muztahiddurjoy/gorur_gari_2026/firmware/i2c_addresses.md

# I2C bus: SDA GPIO8 / SCL GPIO9, 400 kHz (falls back to 100 kHz if the gyro is unreliable)

# OLED DISPLAY (SSD1306): 0x3C
# BOTGyro IMU (ASM330LHH): 0x6A (0x6B if SA0 is tied high)
