muztahiddurjoy/gorur_gari_2026/circuit_diagram/esp32_pin_map.png

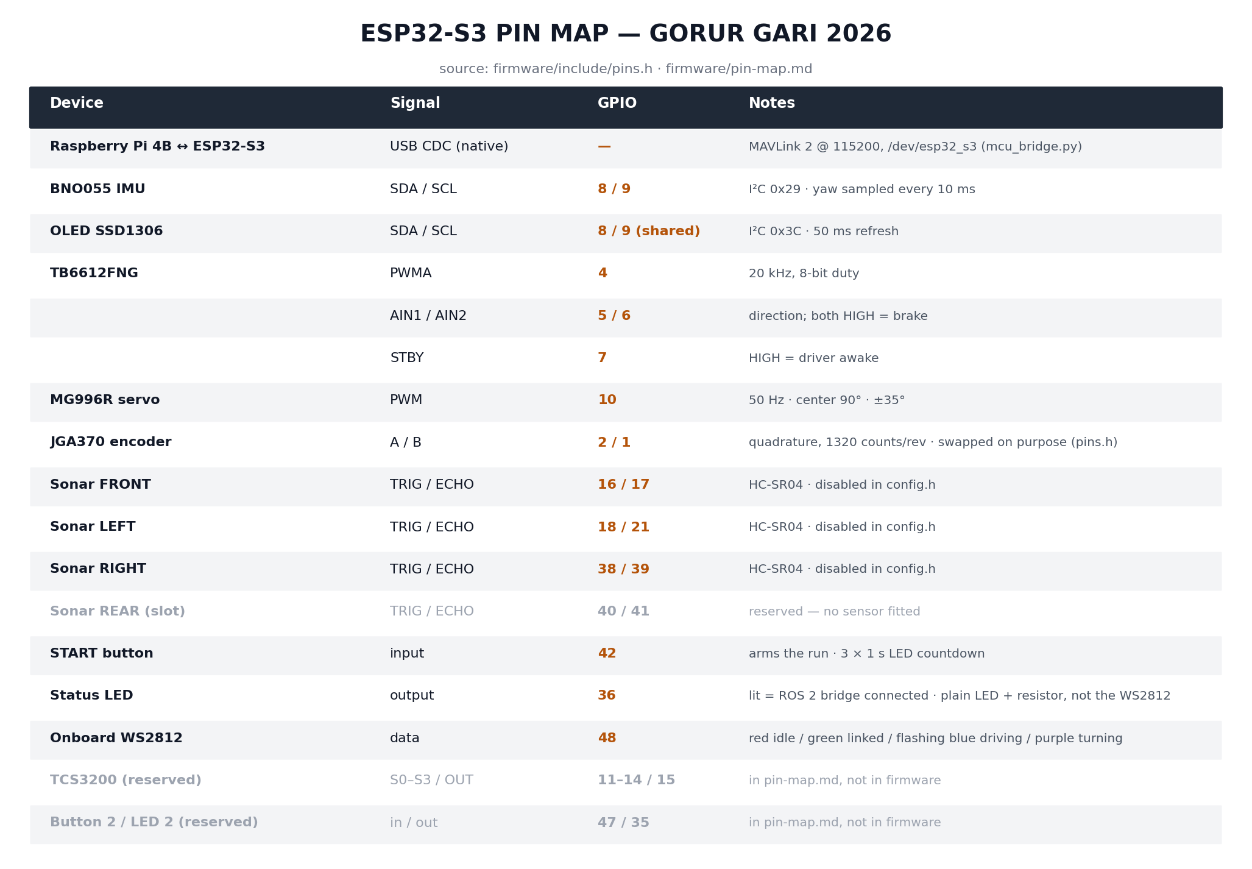
circuit_diagram/esp32_pin_map.png
