muztahiddurjoy/gorur_gari_2026/CAD/gorusim_collision.step

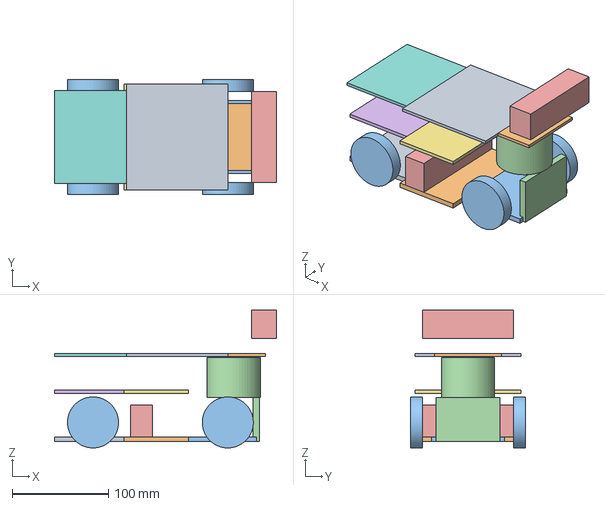
[picture p6: CAD file, 2026-11-05]
CAD/gorusim_collision.step
230.5 x 119.0 x 143.2 mm
