muztahiddurjoy/gorur_gari_2026/gorusim/meshes/camera_link__333.stl

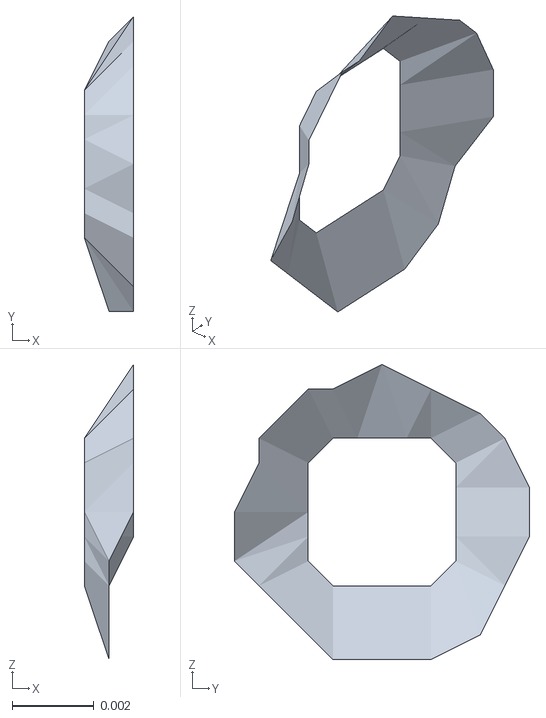
[picture p7: CAD file, 2026-11-05]
gorusim/meshes/camera_link__333.stl
0.0012 x 0.0072 x 0.0072
