muztahiddurjoy/gorur_gari_2026/gorusim/meshes/rear_axle__400.stl

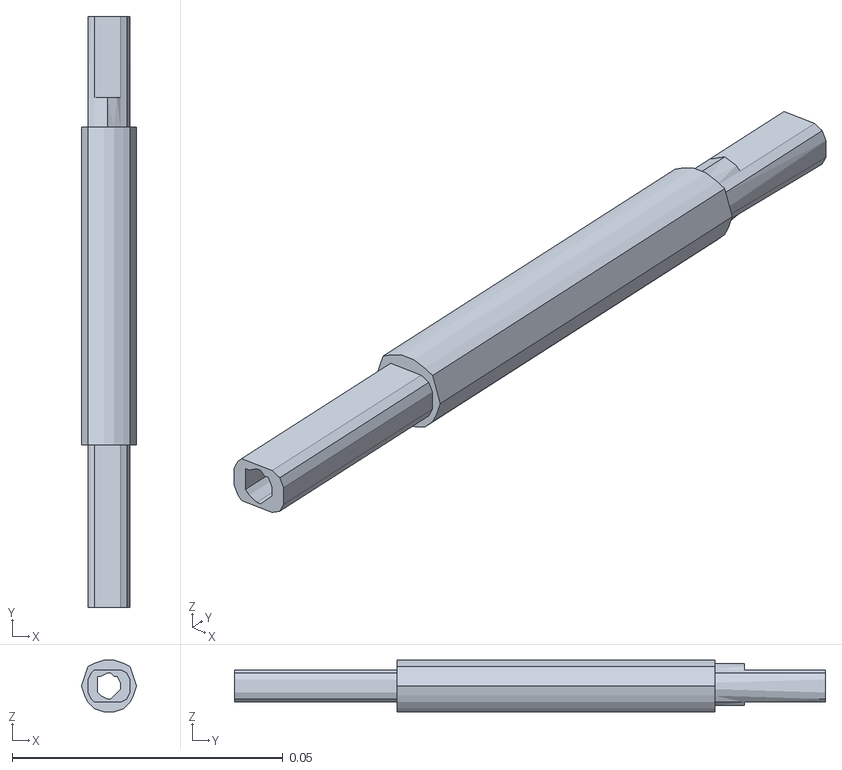
[picture p8: CAD file, 2026-11-05]
gorusim/meshes/rear_axle__400.stl
0.0102 x 0.109 x 0.0096
