muztahiddurjoy/gorur_gari_2026/gorusim/meshes/base_link__555.stl

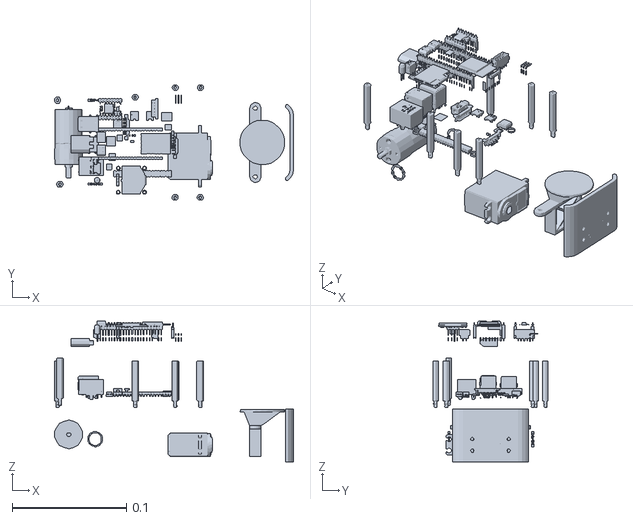
[picture p9: CAD file, 2026-11-05]
gorusim/meshes/base_link__555.stl
0.209 x 0.101 x 0.123
