muztahiddurjoy/gorur_gari_2026/gorusim/meshes/base_link__700.stl

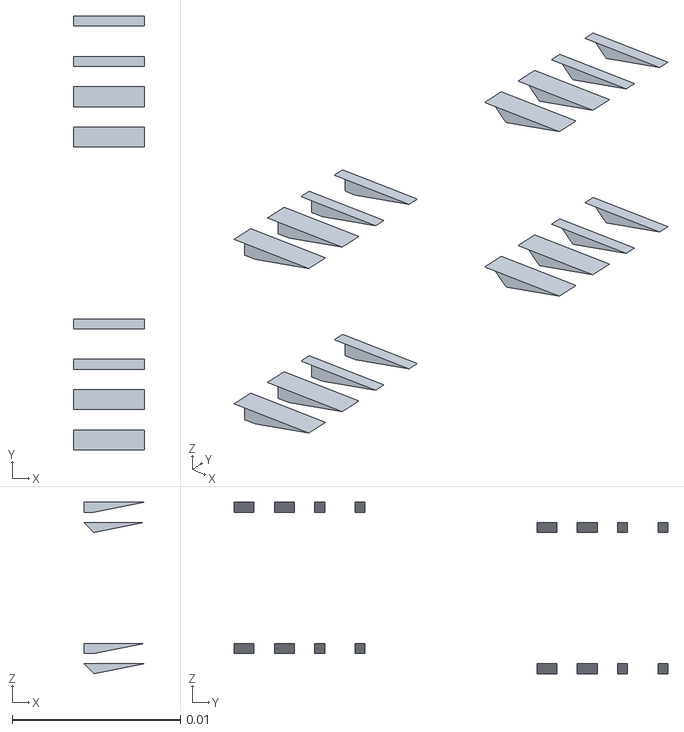
[picture p10: CAD file, 2026-11-05]
gorusim/meshes/base_link__700.stl
0.0042 x 0.0258 x 0.0102
