muztahiddurjoy/gorur_gari_2026/gorusim/meshes/base_link__777.stl

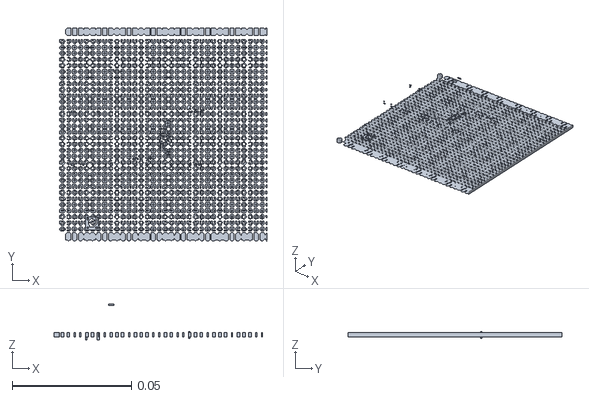
[picture p11: CAD file, 2026-11-05]
gorusim/meshes/base_link__777.stl
0.0894 x 0.09 x 0.015
