muztahiddurjoy/gorur_gari_2026/gorusim/meshes/camera_link__000.stl

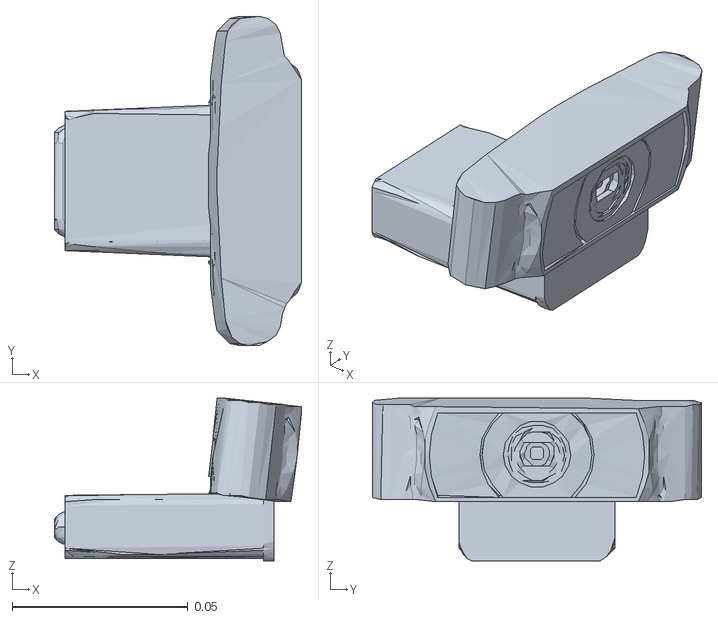
[picture p12: CAD file, 2026-11-05]
gorusim/meshes/camera_link__000.stl
0.0702 x 0.0936 x 0.0462
