muztahiddurjoy/gorur_gari_2026/gorusim/meshes/imu_link__222.stl

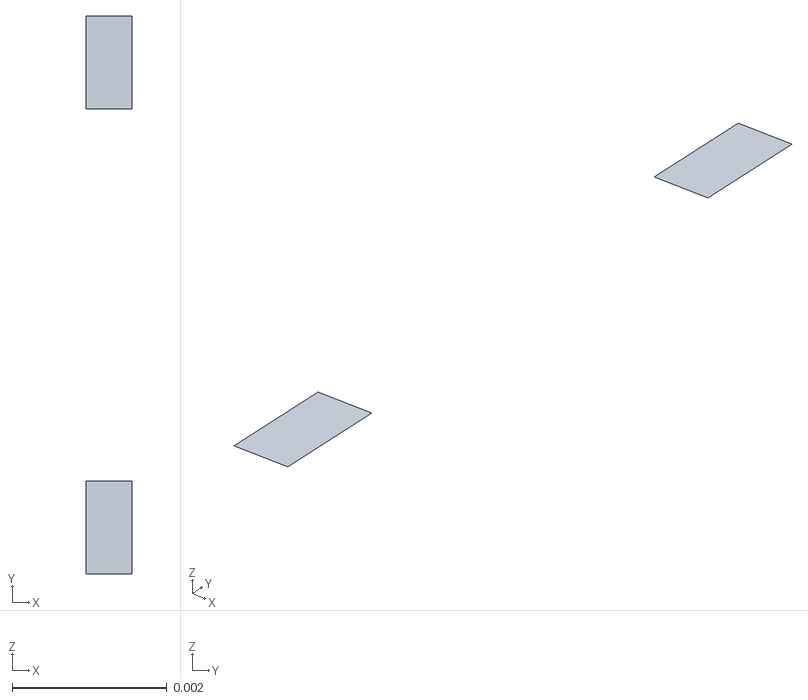
[picture p13: CAD file, 2026-11-05]
gorusim/meshes/imu_link__222.stl
0.0006 x 0.0072 x 0
