muztahiddurjoy/gorur_gari_2026/gorusim/meshes/base_link__000.stl

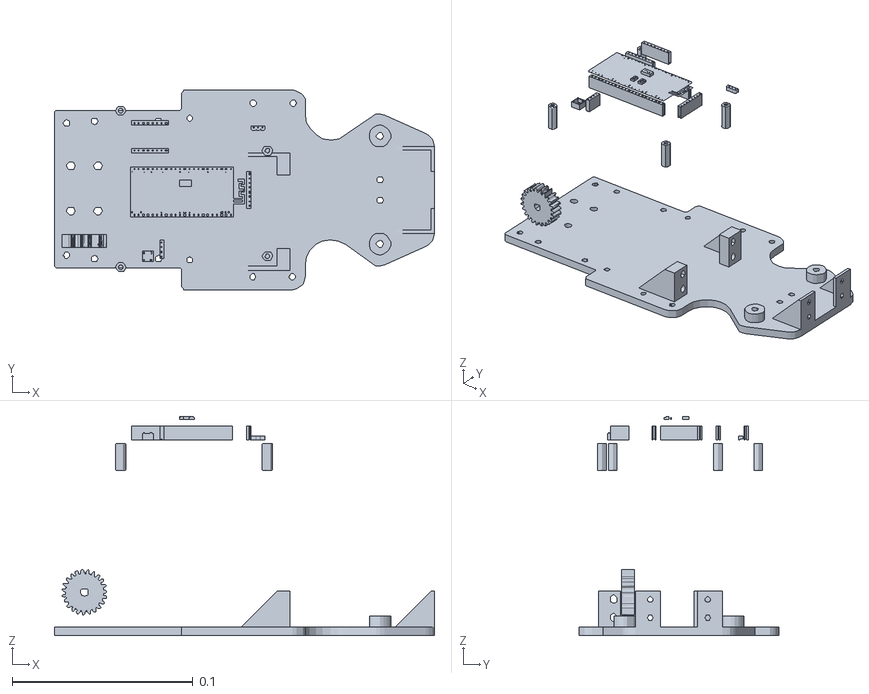
[picture p14: CAD file, 2026-11-05]
gorusim/meshes/base_link__000.stl
0.21 x 0.11 x 0.121
