muztahiddurjoy/gorur_gari_2026/gorusim/meshes/base_link__111.stl

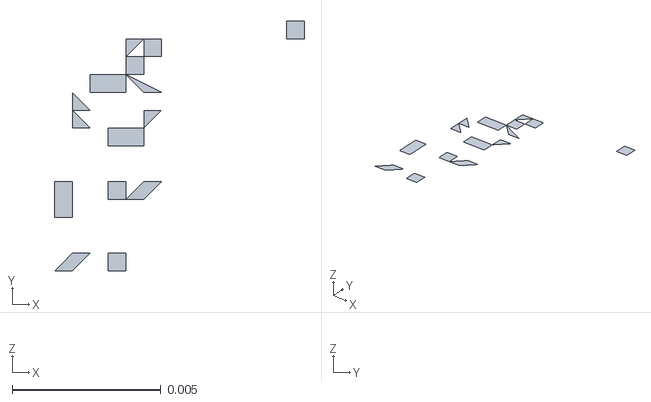
[picture p15: CAD file, 2026-11-05]
gorusim/meshes/base_link__111.stl
0.0084 x 0.0084 x 0
