muztahiddurjoy/gorur_gari_2026/gorusim/meshes/base_link__666.stl

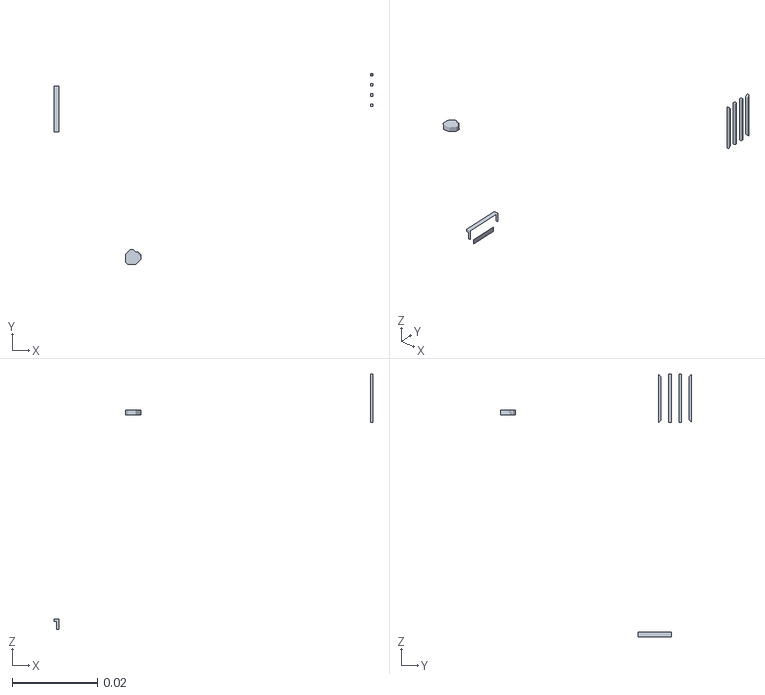
[picture p16: CAD file, 2026-11-05]
gorusim/meshes/base_link__666.stl
0.075 x 0.045 x 0.0618
