muztahiddurjoy/gorur_gari_2026/gorusim/meshes/camera_link__444.stl

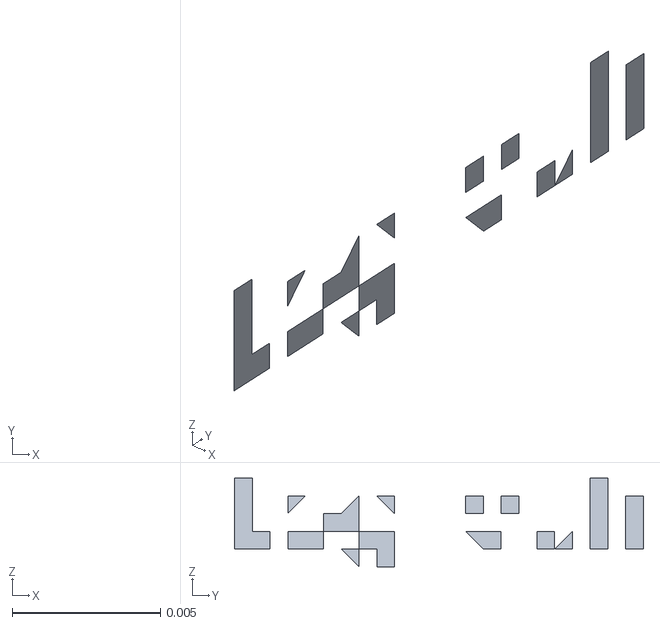
[picture p17: CAD file, 2026-11-05]
gorusim/meshes/camera_link__444.stl
0 x 0.0138 x 0.003
