muztahiddurjoy/gorur_gari_2026/gorusim/meshes/laser__555.stl

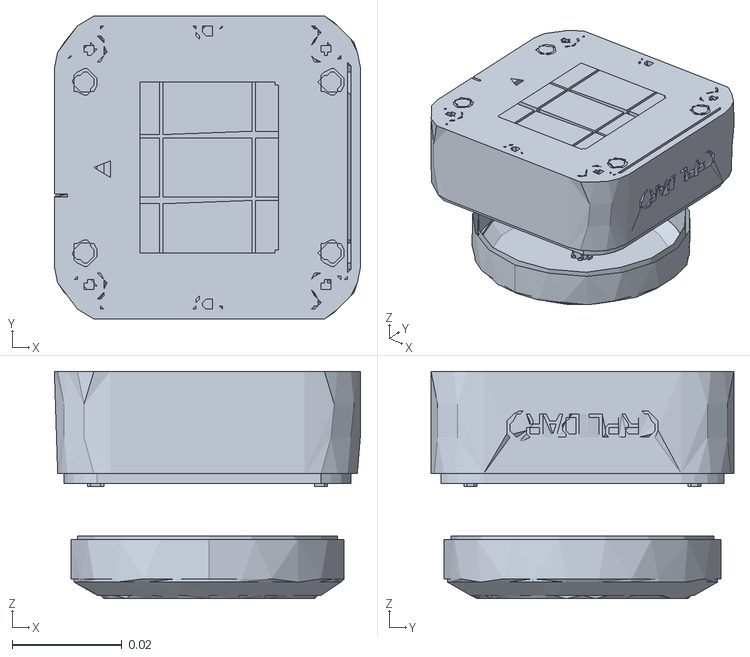
[picture p18: CAD file, 2026-11-05]
gorusim/meshes/laser__555.stl
0.0558 x 0.0552 x 0.0414
