muztahiddurjoy/gorur_gari_2026/gorusim/meshes/base_link__800.stl

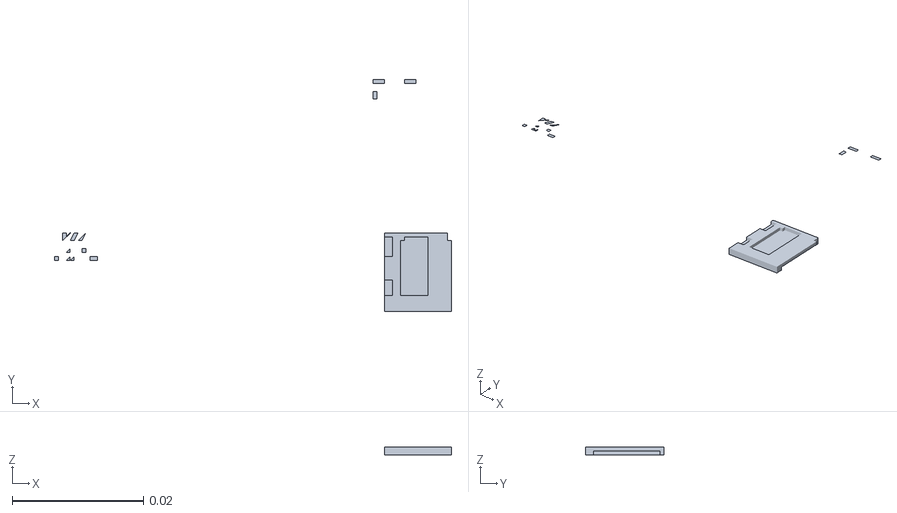
[picture p19: CAD file, 2026-11-05]
gorusim/meshes/base_link__800.stl
0.0606 x 0.0354 x 0.0042
