muztahiddurjoy/gorur_gari_2026/gorusim/meshes/base_link__024.stl

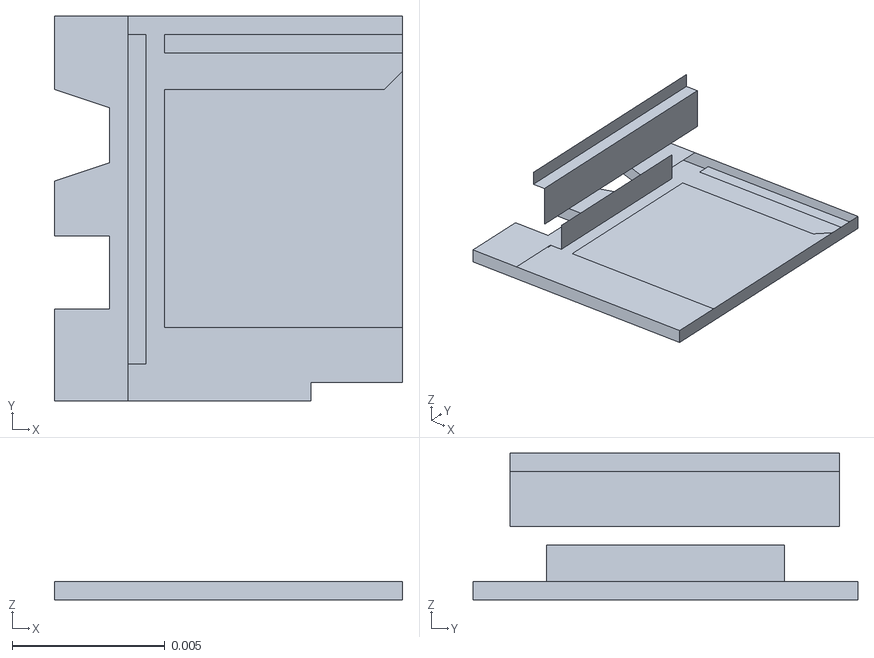
[picture p20: CAD file, 2026-11-05]
gorusim/meshes/base_link__024.stl
0.0114 x 0.0126 x 0.0048
