muztahiddurjoy/gorur_gari_2026/gorusim/meshes/imu_link__555.stl

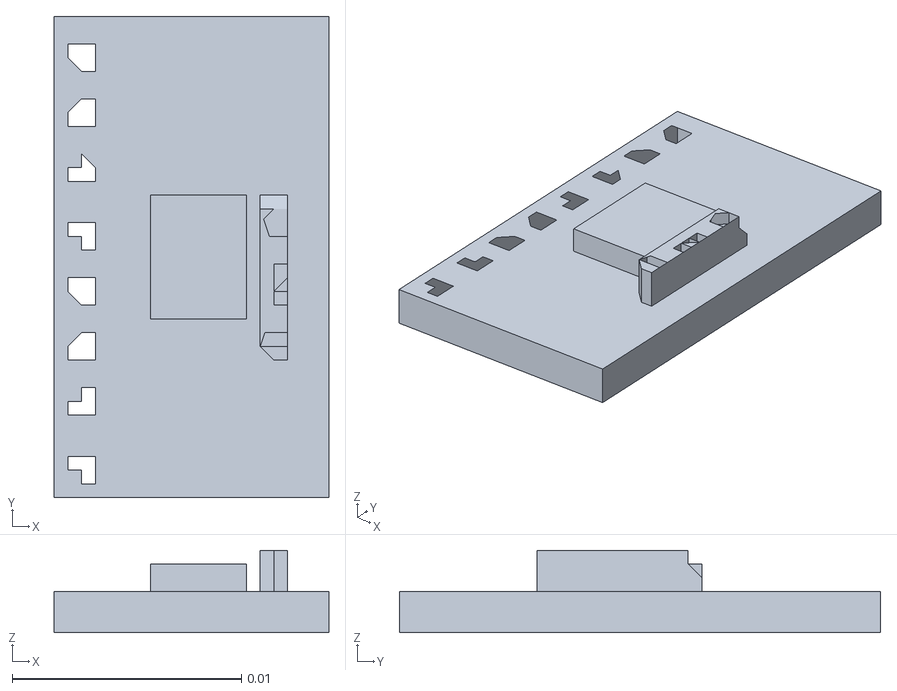
[picture p21: CAD file, 2026-11-05]
gorusim/meshes/imu_link__555.stl
0.012 x 0.021 x 0.0036
