muztahiddurjoy/gorur_gari_2026/gorusim/meshes/base_link__820.stl

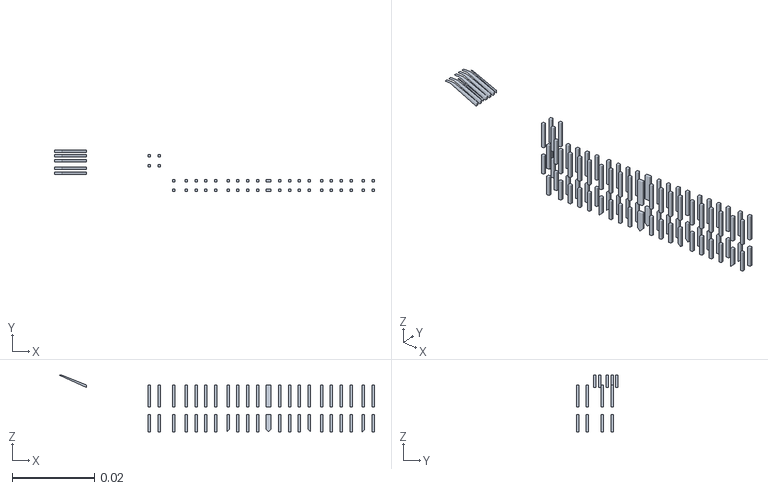
[picture p22: CAD file, 2026-11-05]
gorusim/meshes/base_link__820.stl
0.078 x 0.0108 x 0.0138
