muztahiddurjoy/gorur_gari_2026/gorusim/meshes/base_link__021.stl

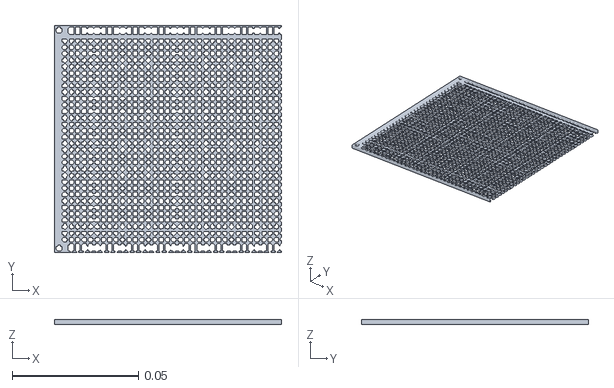
[picture p23: CAD file, 2026-11-05]
gorusim/meshes/base_link__021.stl
0.09 x 0.09 x 0.0018
