muztahiddurjoy/gorur_gari_2026/gorusim/meshes/base_link__151.stl

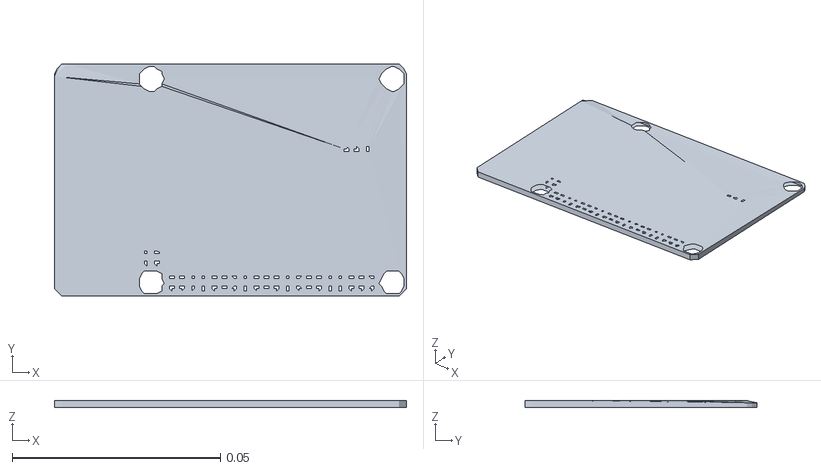
[picture p24: CAD file, 2026-11-05]
gorusim/meshes/base_link__151.stl
0.0846 x 0.0558 x 0.0018
