muztahiddurjoy/gorur_gari_2026/gorusim/meshes/base_link__222.stl

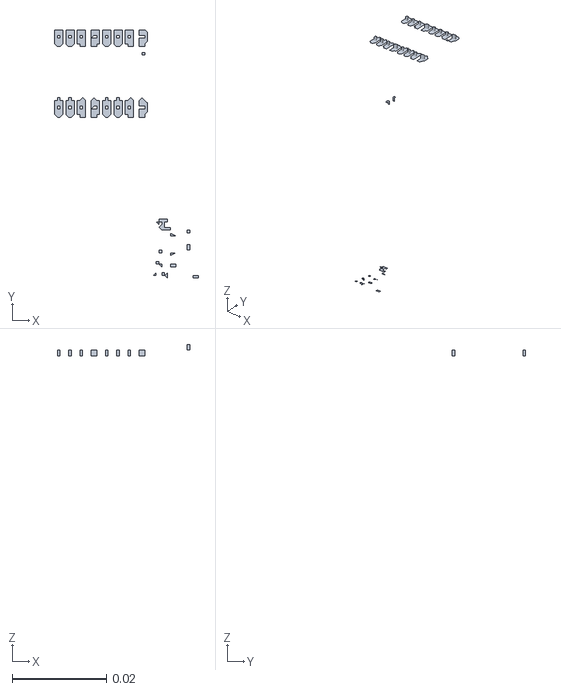
[picture p25: CAD file, 2026-11-05]
gorusim/meshes/base_link__222.stl
0.0306 x 0.0528 x 0.0612
