muztahiddurjoy/gorur_gari_2026/gorusim/meshes/base_link__763.stl

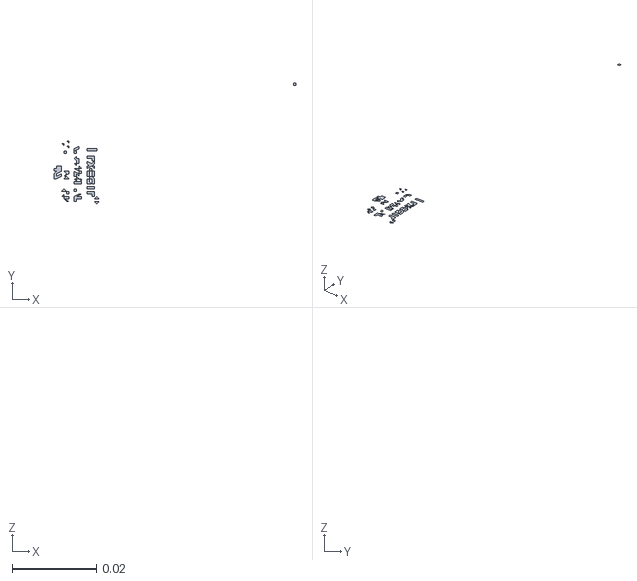
[picture p26: CAD file, 2026-11-05]
gorusim/meshes/base_link__763.stl
0.0576 x 0.0288 x 0.0474
