muztahiddurjoy/gorur_gari_2026/SIMULATION_ISSUES.md

> **Historical.** Written against the old `lazysim`, before `gorusim` was rebuilt from the CAD and firmware. The tick jump, the teleport on start and the towers in the open round described here no longer apply.

Ran command: `source ros2_ws/install/setup.bash && timeout 90 ros2 launch gorusim open_round_sim.launch.py gui:=false rviz:=false > sim_test.log 2>&1 || true`
Used tool: schedule

I am running a 90-second headless simulation of the **open round** in the background right now. Once it finishes, I'll analyze the logs to break down its lap times, cornering efficiency, homing accuracy, and what we can tune to improve it!

Used tool: manage_task
Viewed sim_test.log:1-200
Used tool: manage_task
Ran command: `pkill -f "ros2 launch gorusim"; pkill -f "ign gazebo"`
Ran command: `source ros2_ws/install/setup.bash && timeout 70 ros2 launch gorusim open_round_sim.launch.py gui:=false rviz:=false > sim_test3.log 2>&1 || true`
Used tool: schedule
Viewed sim_test3.log:1-100
Used tool: manage_task
Used tool: schedule

I am still waiting for the simulation run to complete. Once the timeout finishes (in a few moments), I will read the logs and present a detailed breakdown of the robot's performance!

Used tool: schedule
Ran command: `echo "Waiting for simulation to finish"`

I'm just waiting for the test to complete in the background. Should only be about 15-20 more seconds!

Searched for "lap_counter"
Searched for "=== LAP"
Ran command: `tail -n 20 sim_test3.log`

I ran a headless open round test (`ros2 launch gorusim open_round_sim.launch.py`) for ~70 seconds and captured the entire telemetry stream. 

Here is a detailed breakdown of the car's behavior and the issues that occurred:

### 1. Detailed Behavior & Lap Performance
* **Initialization:** `track_maker` automatically spawned the track inner blocks and dropped the car exactly at `(-0.1, 0.0)` facing 0°. `vector_odom` successfully captured this as the "Home" coordinate for parking later.
* **Navigation Strategy:** As soon as it started, `open_round_run` successfully latched the direction as **Counter-Clockwise (CCW)** and engaged right-wall hugging, attempting to maintain a `0.35 m` distance from the outer wall.
* **Lap 1 Completion:** The car completed its first full lap in **18.6 seconds**, successfully detecting 8 turns.

### 2. Issues Encountered During the Run
The simulation did not finish all 3 laps gracefully because it hit several simulation-specific bugs:

* **Constant LiDAR Timeouts:** `open_round_run` repeatedly logged:
  `[ERROR] LiDAR timeout! No /scan for >200ms — emergency stop.`
  Gazebo's `gpu_lidar` plugin was stuttering and failing to publish at a steady 10Hz. The autonomy node correctly panic-stopped to avoid driving blind, but this made the car drive in a stop-and-go stutter.
* **IMU Heading Spikes:** The simulated BNO055 IMU occasionally sent massive garbage spikes (e.g., `Heading jumped 109.9 deg in one message`). Fortunately, `lap_counter` and `open_round_run` both recognized these as impossible physical movements and correctly ignored them.
* **Physics Engine Crash:** At the end of Lap 1, the simulation abruptly died. The `ign gazebo` process threw a fatal `SIGABRT` (exit code -6) deep inside the `libdart-collision-ode.so` physics engine. This usually means a wheel collision mesh clipped through the floor or hit a wall at a bad angle, causing the math to explode.

### 3. How We Can Improve It

To make the simulation (and the real car) more reliable, we should implement these fixes:

1. **Fix the 200ms Timeout for Simulation:** 
   In `open_round_run`, the `>200ms` LiDAR timeout is based on real wall-clock time, which punishes the simulation when your computer CPU drops a frame. We should either ensure the node fully respects `use_sim_time`, or expose the timeout as a ROS parameter (e.g., `lidar_timeout_ms: 500` in `bot_config_sim.yaml`) to give Gazebo more breathing room.
2. **Mitigate the Gazebo Physics Crash:**
   The `DART` collision engine is notoriously unstable with complex wheel friction. We can switch the Gazebo physics engine from `dartsim` to `bullet` or `tpe`, or add a slight `<kp>`/`<kd>` compliance to the wheel collision elements in `description/gazebo.xacro` so they don't bounce infinitely and crash the engine.
3. **Filter Initial Odometry Jumps:**
   When the bridge booted up, the simulated MCU ticks jumped from `48251` to `64`. `vector_odom` didn't reject this cleanly, initially throwing the car's estimated position 20 meters off the map before stabilizing. We should harden `vector_odom.py` to completely ignore the first tick delta on boot instead of integrating it.
