muztahiddurjoy/gorur_gari_2026/(commit log)

2026-08-03 updated for esp32 s3
2026-08-03 Add build logs for 'contols' package installation
    - Created stdout_stderr.log to capture the output of the egg_info, build, and install processes for the 'contols' package.
    - Added streams.log to log the command execution details and its output during the build process.
    - Introduced events.log to track the job lifecycle events, including job queuing, starting, and ending.
    - Generated logger_all.log to provide a comprehensive debug log of the colcon build process, including command line arguments, package discovery, and environment setup.
2026-08-03 motor rear drive issue resolved
    [main.cpp]
2026-08-04 created the display driver
2026-08-04 Add updateScreen method and button handler files
2026-08-05 Add sonar functionality and debug serial logging
    - Introduced SonarReader class for ultrasonic sensor handling.
    - Added sonar pins and configuration in config.h and pins.h.
    - Integrated sonar readings into main loop for telemetry.
    - Updated mcu_bridge.py to publish sonar data to ROS2 topics.
    - Implemented debug serial logging to avoid MAVLink desynchronization.
    [config.h, debug_serial.h, main.cpp, mcu_bridge.py, pins.h]
2026-08-05 Add sonar functionality with enable flags and update ROS2 bridge for sonar integration
2026-08-05 Add build logs for 'contols' package
    - Created stdout_stderr.log to capture standard output and error during the build process.
    - Added streams.log to log the command execution details and output.
    - Introduced events.log to track events during the build lifecycle, including job status and command execution.
    - Generated logger_all.log for comprehensive logging of the build process, including command line arguments and package discovery details.
    [main.cpp, mcu_bridge.py]
2026-08-05 working on the status LED
2026-08-06 Remove status LED functionality and related configurations
2026-08-06 Add velocity data handling to SharedData and update display logic
2026-08-07 sending raw data to the ros2 side for yaw and encoder tick
2026-08-07 attempting to auto steer based on lidar response
2026-08-07 Added fix of claude generated issues
    [disparity_extender.py, disparity_extender_params.yaml]
2026-08-08 Implement BoxLapTestNode for autonomous steering based on odometry and heading inputs
2026-08-08 added push button code
2026-08-08 implemented the button node
2026-08-08 Add status LED functionality and connection message for ROS2 bridge
    - Introduced STATUS_LED_PIN for a plain LED to indicate ROS2 connection status.
    - Updated StatusLed class to manage a single color LED instead of NeoPixel.
    - Implemented connection message (gorur_gari_ros2_to_mcu_connect_msg) to notify MCU of ROS2 bridge status.
    - Modified main loop to handle connection status and update LED accordingly.
    - Adjusted platformio.ini to remove NeoPixel dependency.
2026-08-08 added the status led
2026-08-09 i2c issue resolved
2026-08-09 Enhance GoToController with detailed comments and parameter adjustments for improved steering and heading management
2026-08-09 Add heading offset parameter to GoToController, EncoderOdometryNode, and VectorOdometryNode for accurate heading calculations
2026-08-09 Enhance GoToController with adaptive speed control, goal queue management, and improved steering logic; update VectorOdometryNode to correctly accumulate total distance travelled.
    [goto_controller.py, vector_odom.py]
2026-08-09 Fix encoder pin assignments and update heading offset parameters for consistency across odometry nodes
    [goto_controller.py, pins.h, vector_odom.py]
2026-08-09 Add HSV tuning utility and vision processing node for WRO 2026
    - Implemented `tune_hsv.py`, an interactive tool for tuning HSV parameters and thresholds for detecting red and green pillars using OpenCV and Tkinter.
    - Created `vision_node.py`, a ROS 2 node that subscribes to camera images, applies color mask filtering for pillar detection, and publishes identified obstacles.
    - Introduced `vector_odom.py`, a vector odometry node that calculates position vectors based on encoder data and IMU heading, publishing the results as a Vector3 message.
2026-08-09 Implement start button functionality with countdown and LED indication
2026-08-10 Add CustomDisparityExtender node for enhanced laser scan processing
2026-08-10 Refactor and remove obsolete sensor processing modules
    - Deleted `encoder_odometry.py` and `vector_odom.py` files as they are no longer needed.
    - Removed associated build files and configurations related to the deleted modules.
    - Updated `custom_disparity_extender.py` to enhance disparity edge detection and object width measurement.
    - Improved code structure and added detailed comments for clarity.
    - Updated build logs to reflect the latest changes.
    [custom_disparity_extender.py]
2026-08-10 remove draft vision node package and implement new camera push detector node
2026-08-10 Resolve merge conflict, keep 3 lap auto off and reset lap count at start
    [disparity_extender.py]
2026-08-10 tried new method for fusion (reverrt commit if something goes wrong)
    [disparity_extender.py, disparity_extender_params.yaml, vision_node.py, vision_params.yaml]
2026-08-10 Refactor E-Stop Node for Improved Safety and Functionality
    - Reindented the entire e_stop.py file for proper syntax and readability.
    - Enhanced the lidar data processing with improved range sanitization and median filtering.
    - Updated the reverse recovery logic to utilize odometry data for distance measurement.
    - Adjusted the subscription QoS settings for lidar data to ensure compatibility with BEST_EFFORT publishers.
    - Implemented a state machine for the auto-reverse recovery feature, including safety checks for rear clearance.
    - Added parameters for bot configuration in a new YAML file, allowing centralized management of robot dimensions and operational limits.
    - Improved the engagement an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
    [bot_config.yaml, custom_disparity_extender.py, e_stop.py]
2026-08-11 refactor: replace disparity_extender node with open_round_run for autonomous navigation and update project documentation.
    [disparity_extender.py, new_disparity.py, open_round_run.py]
2026-08-11 feat: update steering angle limits for improved maneuverability
2026-08-11 swapped the encoder pin to avoid the inverted value
    [pins.h]
2026-08-12 imported the sim environment
    [IMU.xacro, camera.xacro, control.xacro, gazebo.xacro, lazyBot.xacro, lazyBotCore.xacro, lazyWorld.sdf, lidar.xacro]
2026-08-13 Add Run Timer Node and associated tests
    - Implemented the Run Timer Node in `autonomy/run_timer.py` to track the duration of runs and display the time on the car's OLED.
    - Created documentation for the Run Timer Node detailing its functionality, architecture, and usage.
    - Added unit tests for the Run Stopwatch and Run Timer Node in `test/test_run_timer.py`, ensuring accurate time tracking and state management.
    - Developed tests for MAVLink message consistency and compatibility in `test/test_mcu_timer_msg.py`, verifying message structure and CRCs against firmware definitions.
2026-08-13 feat: add synchronization mechanism to wait for track initialization before starting simulation autonomy nodes and tune vision parameters.
2026-08-13 Refactor documentation and code to replace USB-to-TTL references with native USB CDC for MAVLink communication
    [debug_serial.h, generate_diagrams.py, main.cpp, mav_serial.h, mcu_bridge.py, pins.h]
2026-08-13 Update parameters for OpenRoundRunNode and custom disparity extender configuration
    - Enable auto steering by default
    - Increase max speed and speed caps for better performance
    - Adjust LiDAR watchdog timeout for improved responsiveness
    - Modify bot configuration for encoder counts, steering lock, and speed limits
    - Enable drive in custom disparity extender
2026-08-13 Update LiDAR parameters and configurations for improved sensor handling and performance
    [lidar.xacro]
2026-08-14 Enhance OpenRoundRunNode with heading-fused steering and encoder stall adaptation; update bot configuration parameters for improved performance.
    [bot_config.yaml, open_round_run.py, vector_odom.py]
2026-08-14 Update corner throttle parameters and add launch file for open round autonomy stack
2026-11-04 Rename the simulator package from lazysim to gorusim
    Purely mechanical: package, Python module, model, world, RViz config and
    /gorubot topic prefix, plus every doc that names them. Credit to Team
    LazyGo stays where it is, the track tooling is still derived from theirs.
2026-11-04 Add CAD extractor: meshes, masses and geometry from WRO_Bot_v2.step
    tools/extract_cad.py reads the STEP assembly with OpenCascade and writes the
    link meshes, per-link mass and inertia, and every dimension the simulator
    needs: wheelbase, track, tyres, kingpins, the steering linkage's joints, and
    the sensor mounts. Outputs are committed so running the sim needs no OCC.
    Masses are the one thing a STEP cannot give, so component weights and
    densities are marked assumptions, with --total-mass-g to scale them once the
    real car has been weighed. tools/steering_lock.py finds where the tyres hit
    the chassis.
2026-11-04 Rebuild the robot description from the CAD
    base_link is now the CAD origin, with the real kingpin offset (23.75 mm, not
    12), a 53 mm tyre (not 50), one solid rear axle joint, the C1 where it actually
    hangs (76 mm ahead, scan plane 68.25 mm) with the driver's real -179..180 grid,
    and a fixed C920: the pan servo in the old model does not exist on the car.
    Drive is the DC motor equation at the physics rate, not a velocity command.
2026-11-04 Replace the bridge stand-in with an emulated ESP32
    sim_mcu runs firmware/src/main.cpp's behaviour behind a pty, so the real
    mcu_bridge runs unmodified over MAVLink: launch boost, scaling and clamps are
    the real code. It models 8 bit duty (a full int8 is under 50%), servoCorrection
    = 23 (uneven left/right travel), MG996R slew, the 50 ms rpm sampling and
    telemetry, the BNO055's heading, and no drive watchdog, as on the car.
    linkage.py solves servo horn -> rod -> tie bar -> knuckles from the CAD's joint
    positions, so Ackermann comes out of the geometry instead of being assumed.
2026-11-04 Run the real config, spawn on the start pose, separate the open round track
    config/ now symlinks the real ros2_ws/config files, with sim_overlay.yaml as the
    short list of what the sim changes, replacing a copy that had drifted. The launch
    files use the same parameters as the real ones and add the real mcu_bridge and
    run_timer. The car spawns on its start pose instead of being teleported under a
    live encoder, and the open round runs on a bare mat. flatWorld and
    tools/verify_dynamics.py check how the car actually drives.
2026-11-04 Add unit tests, the simplified collision CAD, and separate static friction
    Tests cover the linkage geometry, the firmware constants (read from firmware/
    itself so they cannot drift), and agreement between the generated description
    and the sim and real configs. CAD/gorusim_collision.step is the convex model the
    physics engine uses, built in SolidCraft from the same plates' dimensions.
    Rolling and static friction are now separate, because the repo pins each from a
    different side: linear.x 0.40 is a rolling creep speed in bot_config, while the
    journal has standing starts at that level sometimes humming until the launch
    boost. The C1's optical window is left out of the visual mesh so the beam c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
2026-11-04 Run vision_node on the system NumPy, compare odometry at rest, tidy lint
    cv_bridge is built against NumPy 1.x and segfaults under a NumPy 2 in ~/.local,
    so the obstacle launch gives vision_node PYTHONNOUSERSITE. verify_dynamics now
    compares ticks with ground truth once stopped: telemetry can be 50 ms old, which
    is 2-3% of a short run at speed and made the check fail by chance.
2026-11-05 Add competition_arena.world: 3 x 1 m track, walls, start and finish zones
2026-11-05 Add robot.urdf.xacro: skid-steer base, mast camera, ground truth publisher
2026-11-05 Fix camera view: raise the near clip that hid the boxes, use pure box colours
    A near clip of 0.02 m drew a flat band over the frame from the horizon to the image
    centre. The boxes are now full red and green, and the finish checks darker, which
    leaves a clear brightness gap between a green box and the finish zone.
2026-11-05 Add box and finish detection to smart_navigation, with tests
    Locates a box by where its base meets the floor, ignoring blobs whose base is cut off or
    hidden. On rendered frames this puts boxes within 1-3 cm of the truth out to 1.3 m.
2026-11-05 Add smart_navigation control: red left, green right, then back to the track direction
    Boxes are remembered in the odom frame, since one leaves the frame while the robot is still
    alongside it. Each colour can only push the lane one way, so red can only cause a left turn
    and green a right one.
2026-11-05 Add referee and multi-seed trial runner: score runs from ground truth
2026-11-05 Calibrate the skid-steer's effective track against ground truth
    The true turn rate was 0.62x what /odom reported with the geometric track, so odometry
    drifted 9 cm over one run. The referee's wall gap also no longer counts the wall behind the
    start zone, which the robot starts next to by design.
2026-11-05 Take heading from a gyro: wheel odometry cannot see a skid-steer's slip
    Ground truth showed /odom ending 18 degrees and 50 cm off, which caused the 7 failures
    in 20 layouts. The robot gets an IMU, and the node dead-reckons from gyro heading and wheel
    speed.
2026-11-07 Let any node drive the status LED through mcu_bridge
    /status_led (Bool) sets it steady on or off and /status_led/blink (Float32,
    Hz, <= 0 stops) toggles it on a timer. No firmware change: both go out as the
    existing connect frame, which main.cpp turns into status_led.set(). Nothing
    is sent before the one-shot connect notice, which now carries the requested
    level instead of always 1.
2026-11-07 Test the status LED blink rate and the firmware frame it relies on
2026-11-07 Emulate the status LED in sim_mcu and show it in RViz
    Port of StatusLed: set() from the connect frame, plus the start countdown
    blink on a button press. The level goes out latched on /gorusim/status_led
    and as a sphere marker above the car on /gorusim/status_led_marker.
2026-11-07 Test the simulated status LED against StatusLed's behaviour
2026-11-07 Show the status LED marker in the sim's RViz layout
2026-11-07 Document the status LED topics and how the sim shows them
2026-11-07 Log the bridge hello once in sim_mcu, not on every LED toggle
2026-11-07 Declare std_msgs, geometry_msgs and sensor_msgs deps for local_comp
2026-11-07 Enhance OpenRound node with LIDAR data processing and button control
2026-11-09 Added 4 new harder tracks, Colored Pillars (For top view)
    Total tracks now - 10
    Following track is failing - 7
    Need further investigation
2026-11-09 Added Open Round code and organized repo
    - Open round code works in simulation (no wall hugging, biased to middle of the path)
    - I think we can make the steering smoother as right now it wobbles. Researching more about PID smooth cornering
    - Organized the repository
2026-11-11 firmware: pin ESP32Servo 3.x and document the Arduino core in use
    The registry espressif32 platform resolves to Arduino core 2.0.17, not 3.x.
    Say so next to the platform line, note the pinned pioarduino release that
    gives core 3.x, and pin ESP32Servo to 3.2.x (it supports both cores).
2026-11-11 firmware: drop the sonars from the pin map
    No sonars are fitted on the new hardware, and their old pins now belong to
    the steering servo (GPIO16) and the UART link to the Pi (GPIO40/41).
    The mcu_to_ros2 message keeps its four sonar fields; they always carry 255,
    which mcu_bridge already reads as 'no reading'. lib/sonar_reader is left in
    place, just no longer built.
2026-11-11 firmware: talk to the Pi over the GPIO UART, keep USB for debug
    MAVLink now runs on Serial1 (TX GPIO40, RX GPIO41, 115200 8N1) through the
    6N137 optocouplers to the Pi's /dev/ttyAMA0. The native USB port is debug
    only: DEBUG_SERIAL is Serial, with the HWCDC TX timeout set to 0 so a host
    that enumerates the port but never reads it cannot stall loop() for 100 ms
    per print. Serial1 gets 512 byte TX/RX ring buffers so telemetry writes
    never wait for the wire.
2026-11-11 firmware: drive the motor through a BTS7960 instead of the TB6612
    MotorController now runs RPWM (GPIO5) and LPWM (GPIO6) as two 20 kHz
    ESP32PWM channels with R_EN+L_EN on GPIO7. Forward lowers LPWM before
    raising RPWM, reverse the other way round, so the two PWM pins are never
    both driving. brake = both PWM 0 + EN high, coast = EN low.
    The output is slew limited (MOTOR_SLEW_PERCENT_PER_S, 500 %/s) and a
    direction change always lands on zero for one update before the other side
    drives. brake()/coast() bypass the ramp for the safety paths.
    Fixes the scaling bug: the int8 wire throttle (max 127) used to be written
    straight into an 8-bit duty, topping out near 50 %. +/-127 now maps to full
    dut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
2026-11-11 firmware: host-side tests for the motor driver
    test/host builds pure-logic firmware modules with the system g++ against
    stub Arduino/ESP32PWM headers that log every pin write, then checks the
    BTS7960 contract on that log: write order per direction, RPWM and LPWM
    never both non-zero, zero crossing on reversal, slew rate, immediate brake,
    coast/re-enable and full-range scaling. Run with
    firmware/test/host/run_host_tests.sh; pio ignores the folder.
2026-11-11 firmware: steering servo on GPIO16, limited in microseconds
    The MG996R now hangs off GPIO16. SteeringController maps the 0..180 wire
    angle piecewise-linearly onto STEERING_MIN_US / CENTER_US / MAX_US
    (config.h), so the centre trims independently of each side's travel and
    no wire value can drive the linkage past its limits; ESP32Servo is attached
    with the same limits as a second clamp. Defaults are a conservative
    +/-400 us around 1500 us and must be calibrated on the bench.
    Host tests cover the map and sweep -300..600 against the limits.
2026-11-11 firmware: status LED on GPIO4, start button is the BOOT button
    GPIO36 belongs to the octal PSRAM on the N16R8 module, so the status LED
    moves to GPIO4. The separate push button (GPIO42) is gone: the start
    button is now the devkit's BOOT button on GPIO0, read with INPUT_PULLUP
    (active low) after boot only, never driven, debounced for 30 ms, and
    otherwise behaving exactly as before (press latch to telemetry, 3 s LED
    countdown).
2026-11-11 firmware: move only while valid drive commands keep arriving
    New safety rule. The motor is braked from boot until the first valid drive
    command, and whenever the newest one is older than CMD_TIMEOUT_MS (100 ms)
    loop() brakes at once (no ramp) and centres the steering until the next
    valid one arrives.
    Only a frame mavlink_parse_char() accepts as MAVLINK_FRAMING_OK (CRC with
    CRC_EXTRA, length), with the gorur_gari_ros2_to_mcu_msg id and a steering
    angle in 0..180 counts (lib/drive_link). Connect/timer frames, heartbeats,
    bad CRCs and anything else never refresh the watchdog. The check runs every
    pass, after the serial input. Timeout and resume are logged on USB at most
    once a second, with a c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
2026-11-11 firmware: loop() never waits on the shared-data mutex
    loop() used to block (portMAX_DELAY) on the mutex it shares with the I2C
    task, and built Strings while holding it. It now only tries the lock
    (timeout 0), copies raw numbers, and skips the exchange for one pass if the
    other core happens to hold it. The I2C task copies the struct out and
    formats the OLED text after releasing the lock. Run timer frames are
    parked and handed over at the next exchange instead of taking the lock
    from inside the serial parser.
2026-11-11 firmware: replace the BNO055 with the BOTGyro
    The Adafruit BNO055 / Unified Sensor code and dependencies are gone; the
    BOTGyro library (pinned to the commit its API was checked against) is
    built straight from its library.properties.
    lib/heading now wraps BOTGyro on the I2C task (core 0), never in loop():
    begin() and BOTGyro's own fault recovery block ~120 ms in delay().
    - Wire.setPins(8, 9) + Wire.begin() in setup(), before gyro.begin();
    400 kHz shared with the OLED, whose driver is given the same clock so it
    no longer drops the bus to 100 kHz after every frame.
    - gyro.update() every pass of the I2C task; calibration only via the
    non-blocking startCalibration(), (re)started whenever t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
2026-11-11 firmware: hold drive commands until the IMU is calibrated, report IMU state
    - Drive commands are ignored (no watchdog refresh, motor stays braked)
    until the gyro's first calibration has finished, or IMU_CAL_GATE_MAX_MS
    (5 s) after boot, so a missing IMU cannot keep the car from driving.
    The gate never closes again once open.
    - Status LED: fast 5 Hz blink while calibrating (keep still), a short blip
    once a second while the IMU is missing, faulted or uncalibrated. The
    start countdown still outranks it; the link level returns afterwards.
    - MAVLink STATUSTEXT to the Pi on every IMU state change, repeated every
    5 s while the IMU is unusable.
    - A once-a-second USB status line: drive st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
2026-11-11 firmware: fall back to 100 kHz I2C when gyro reads are unreliable
    After I2C_FALLBACK_AFTER_FAILURES (3) gyro faults, or begin() failures
    while something still ACKs the gyro's address, the shared bus is
    re-clocked from 400 kHz to 100 kHz for the rest of the run:
    BOTGyro::setI2CClock() for its next begin(), Wire.setClock() for the bus
    (which BOTGyro's own re-init uses) and a rebuilt OLED driver, which then
    redraws once a second instead of five times. Logged on USB and sent to the
    Pi as a STATUSTEXT once.
2026-11-11 firmware: core 3.x RGB pixel call, tidy telemetry comment
    Use rgbLedWrite() on Arduino core 3.x, where neopixelWrite() is marked
    deprecated (the one warning the old code gave on core 3), and keep
    neopixelWrite() on 2.0.17. Say in the telemetry code that the heading
    field is now a relative, wrapped yaw; drop an unused parameter.
2026-11-11 mcu_bridge: GPIO UART, 50 Hz drive stream, MCU status text
    - MCU_PORT and bot_config.yaml's port are now /dev/ttyAMA0, the Pi's GPIO
    UART (via 6N137 optocouplers to the ESP32's UART1), not the USB CDC alias.
    - /cmd_vel is no longer forwarded as it comes. The latest command is
    re-sent at a fixed 50 Hz while /cmd_vel is fresh (< 0.3 s old), so the
    firmware's 100 ms drive timeout rides through four lost frames. Once it
    goes stale nothing is sent and the firmware brakes on its own timeout;
    start/stop of the stream is logged once each.
    - STATUSTEXT (#253) from the firmware arrives as UNKNOWN_253 through the
    generated mcu_to_ros2 dialect; it is now decoded with pymavlink's common
    dia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
2026-11-11 controls: tests for the drive stream and MCU status text
    - firmware CMD_TIMEOUT_MS, PI_UART_BAUD and the bridge's constants agree,
    and 50 Hz leaves room for four lost frames inside the 100 ms timeout
    - the port is /dev/ttyAMA0 in the code and in bot_config.yaml
    - freshness boundaries
    - STATUSTEXT from pymavlink and from firmware/include/mavlink_link.h
    (compiled with g++ on the host) goes through the bridge's own dialect
    parser as UNKNOWN_253 and decodes; a corrupted one does not; telemetry
    right behind it still parses
    - the real MCUBridgeNode on a pseudo terminal: /cmd_vel at only 5 Hz still
    yields >= 40 drive frames a second with no gap over 60 ms, and nothing is
    sent once /cmd_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
2026-11-11 docs: new hardware - BTS7960, MG996R on GPIO16, BOTGyro, UART link
    - pin-map.md rewritten for the ESP32-S3-DevKitC-1 N16R8: BTS7960 on 5/6/7,
    servo 16, encoder 1/2, I2C 8/9, BOOT button on 0, status LED 4, UART to
    the Pi on 40/41 via 6N137, GPIO35-37 reserved for the octal PSRAM; motor
    state table, servo calibration, LED priorities, the 100 ms drive rule.
    - README: the same pin table, the new parts in the components table, the
    UART link and the move-only-while-commands-arrive rule, the integrated
    (relative, drifting) heading, power table, failure handling, and the
    Pi UART setup step (enable_uart, disable-bt, console off).
    - QUICKSTART: /dev/ttyAMA0, LED on GPIO4 with the IMU patt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
2026-11-11 circuit_diagram: regenerate for the new hardware
    generate_diagrams.py now draws the BTS7960 on GPIO5/6/7, the MG996R on
    GPIO16 with its own 6 V buck, the BOTGyro at 0x6A, the BOOT button on
    GPIO0, the status LED on GPIO4, the UART link to the Pi through 6N137
    optocouplers (GPIO40/41, /dev/ttyAMA0), no sonars, and GPIO35-37 reserved
    for the octal PSRAM. PNG/SVG regenerated; README mermaid and notes match.
2026-11-11 firmware: no text on the link; events go to the Pi as STATUSTEXT
    Every Serial print in the firmware (main, heading, display, rc_car) now
    goes through DBG_PRINT/DBG_PRINTLN/DBG_PRINTF, which compile to nothing
    unless -D DEBUG_PRINTS=1 - documented as bench tests without the Pi only,
    since the USB port is about to carry MAVLink. Drive events (first command,
    resume, timeout, IMU hold, IMU gate) and a servo attach failure are sent as
    rate-limited MAVLink STATUSTEXT from loop() via statusTextf(), next to the
    existing IMU and I2C fallback reports.
2026-11-11 firmware: MAVLink to the Pi over the native USB port
    The Pi now plugs into the devkit's "USB" port (USB-Serial/JTAG, VID 303a).
    platformio.ini sets ARDUINO_USB_MODE=1 + ARDUINO_USB_CDC_ON_BOOT=1 so that
    Serial is that port, and MAV_SERIAL (config.h) is Serial. Serial1, its
    begin() on GPIO40/41 and the PI_UART pins are gone; GPIO40/41 are unused.
    include/mav_serial.h: mavSerialBegin() sizes the HWCDC ring buffers (1 KB
    each), never waits for a host and sets the TX timeout to 0;
    mavWriteFrame() writes a whole MAVLink frame or drops it when the buffer
    cannot take it, so a closed port neither blocks loop() nor sends half
    frames. DEBUG_SERIAL is the same port, hence DEBUG_PRINTS stays 0.
    Co-Aut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
2026-11-11 firmware: brake at once when the USB host disappears
    HWCDC::isPlugged() (via mavHostPresent()) tracks the USB start-of-frame
    packets the host sends every millisecond and drops a few ms after they
    stop. While a drive command is in force and the host is gone (cable
    pulled, Pi off), loop() now brakes and centres immediately instead of
    waiting out the 100 ms timeout, reports it as a STATUSTEXT (delivered when
    the host is back) and shows 'Cmd: STOP (no USB)' on the OLED. Motion again
    only needs a new valid drive command. An application closing the port is
    not visible this way; the 100 ms timeout covers that.
2026-11-11 mcu_bridge: USB link to the ESP32 with automatic reconnect
    - Opens the ESP32 by its stable udev name /dev/gorur_mcu, falling back to
    /dev/ttyACM0 (parameter fallback_port; the simulator sets it to '' so it
    can never grab real hardware). bot_config.yaml follows.
    - pyserial directly instead of mavutil: no hardware flow control, reads
    never wait, writes time out after 10 ms (write_timeout=0 busy-loops in
    pyserial when the tty is full). After opening, RTS is dropped BEFORE DTR:
    the S3's USB-Serial/JTAG holds the chip in reset on RTS high / DTR low,
    which the other order would pass through.
    - A port that fails a read or write is closed and reopened every 1 s for as
    long as it takes,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
2026-11-11 udev names for the MCU and LiDAR, tests for the USB link
    - ros2_ws/config/99-gorur.rules: /dev/gorur_mcu for the ESP32's native USB
    (VID 303a) and /dev/rplidar for the RPLIDAR's CP2102 (10c4:ea60), with
    install steps in the file.
    - The three launch files with an rplidar_node default to /dev/rplidar.
    - test_drive_stream.py: port/baud constants, the udev rules, that
    open_mcu_port() disables flow control and drops RTS before DTR after
    opening, and the real node losing its port (EIO), retrying while it is
    missing and reconnecting by itself with a new connect notice and the
    drive stream resumed.
2026-11-11 docs: Pi link is native USB on the devkit's "USB" port
    README, QUICKSTART, pin-map and the circuit diagrams now show the USB
    cable into the devkit's "USB" port (native USB CDC, VID 303a,
    /dev/gorur_mcu) carrying MAVLink only, GPIO40/41 unused, the immediate
    brake on USB host loss, and DEBUG_PRINTS for bench tests without the Pi.
    The GPIO-UART setup step (enable_uart, disable-bt, serial console) is
    replaced by the udev rules install and marked not needed; the 6N137 row
    is gone from the parts table. Diagrams regenerated.
2026-11-11 firmware: trim steering centre to 1533 us (~3 deg right)
    At 1500 us the wheels sat slightly left of straight.
2026-11-11 firmware: set steering centre trim in degrees
    STEERING_CENTER_TRIM_DEG (+3, right) now derives STEERING_CENTER_US
    instead of a hand-computed pulse. Same 1533 us result.
2026-11-12 launch: gorur_round - local_comp open/obstacle driver chosen by round:=
2026-11-12 systemd: gorur-round helper to show or switch the boot round
2026-11-12 launch: keep mcu_bridge up when the LiDAR driver is not built
2026-11-12 mcu_bridge: reset a silent ESP32 over USB after 4 s without telemetry
2026-11-12 firmware: center the steering pulse range on the trimmed centre
    The -23 deg trim puts STEERING_CENTER_US at 1245 us, which left only
    300 us of travel to the left (945) against 500 us to the right (1745).
    Move MIN to 745 so both sides swing 500 us, and fix the stale centre
    comment.
2026-11-12 open_round_run: let fallback steering reach full lock
    str_ang_thresh was left at the in-code 180, so the raw-LiDAR fallback
    and homing steering (target_deg / str_ang_thresh) topped out near
    +/-0.5, about 45-135 on the servo. Set it to 90 in bot_config. Also fix
    the comments that still described the old 60 deg bridge gain.
2026-11-12 firmware: drive right lock to the servo's 0 deg endpoint (500 us)
    z = -1 (wire 0) turns right on this car, the ROS convention, and
    stopped about 22 deg of servo short at 745 us. Send the full 500 us.
    Also fix the comments that called wire 0 full left.
2026-11-12 mcu_bridge: label steering clamps with the real directions
    Wire 0 / angular.z -1 is full right, 180 / +1 is full left.
2026-11-12 mcu_bridge: keep driving through 0.7 s of /cmd_vel silence
    CMD_VEL_STALE_S 0.3 -> 0.7: the bridge keeps re-sending the last
    command for 0.7 s after /cmd_vel stops, then the firmware's 100 ms
    link watchdog brakes (~0.8 s total). The firmware timeout is left at
    100 ms so a dead USB link still stops the car fast.
2026-11-12 firmware: ENCODER_COUNTS_PER_REV = 400 ticks per wheel revolution
    The 57 mm wheel turns once per 400 ticks at the tick stream. The old
    1320 (nameplate 11 ppr x4 x 30:1) never matched the real tick rate, so
    the rpm the MCU reported was ~3.3x too low. Only rpm() uses it; odometry
    integrates the raw tick count.
    sim_mcu mirrors the constant (test_sim_mcu checks they agree).
2026-11-12 vector_odom: default to the 57 mm wheel at 400 ticks per revolution
    In-code defaults were a stale 50 mm / 185 ticks. The comment claiming the
    tick stream disagrees with the firmware's ENCODER_COUNTS_PER_REV no longer
    holds: both are now 400.
2026-11-12 launch: odometry on the 57 mm wheel at 400 ticks per revolution
    gorur_base (the autostart vector_odom) and the round launch files now
    default to wheel_diameter_m 0.057 and encoder_counts_per_rev 400, i.e.
    0.4477 mm/tick (was 0.065 / 363 / x0.976 = 0.549 mm/tick).
    distance_scale goes back to 1.0: the 0.976 was a tape-measure correction
    for the old 65 mm / 363 setup and does not carry over to a different
    wheel. Re-measure it on the new wheel.
2026-11-12 bot_config: record the 57 mm wheel and 400 ticks per revolution
2026-11-12 sensors_processing: legacy encoder_odometry on the 57 mm / 400 tick wheel
2026-11-12 gorusim: follow the car onto 0.4477 mm per tick
    The sim launch files hand vector_odom the car's new calibration (0.057 m,
    400 ticks, scale 1.0), and sim_mcu's ticks per wheel turn becomes
    400 * 0.053 / 0.057 = 371.93 around the CAD's 53 mm tyre, so the sim
    still produces the same distance per tick the car does.
2026-11-12 docs: encoder calibration is 400 ticks per 57 mm wheel revolution
    README, the engineering journal and the circuit block diagram (regenerated)
    now give the measured 400 counts per wheel turn. The journal keeps the old
    65 mm / 363 / 0.976 calibration as history and notes the scale is 1.0 on
    the new wheel until a tape-measure run says otherwise.
2026-11-12 firmware: 5 s start countdown on the LED, press sent at once
    START_BLINK_COUNT 3 -> 5: the status LED now blinks once a second for
    5 s after a start button press and goes solid when the car moves, which
    is the delay both local_comp round drivers already wait.
    A press also forces a telemetry frame out immediately instead of riding
    the next 50 ms one, so ROS2 times the start delay from the same instant
    the LED countdown begins. sim_mcu mirrors both.
2026-11-12 local_comp: start exactly start_delay_sec after the button press
    Both round drivers polled a hard-coded 5.0 s in their 20 Hz loop, so the
    car moved anywhere up to 50 ms late. The press edge now arms a one-shot
    timer of start_delay_sec (default 5.0, a parameter now) and the first
    drive command goes out from that timer callback: measured 5001 ms from
    press to /cmd_vel.
    Only the press edge counts (the MCU repeats True while the button is
    held), and a second press during the countdown restarts it, as the
    firmware's LED countdown does. A press while running is still ignored.
2026-11-12 config/round_select.yaml: pick what the start button starts
    One file now says which round driver gorur_round.launch.py starts (open
    -> local_comp open_round, obstacle -> local_comp obstacle_round) and how
    long after the button press it drives (start_delay_sec, 5.0). The launch
    file validates it, logs the choice, and hands start_delay_sec to the
    driver over its tuning yaml. round:= still overrides it for one launch.
    test_round_select checks the committed file, that the firmware's LED
    countdown (START_BLINK_COUNT x START_BLINK_INTERVAL_MS) lasts exactly
    start_delay_sec, and what the loader accepts and rejects.
2026-11-12 systemd: take the boot round from config/round_select.yaml
    gorur-round.service no longer passes round:=${GORUR_ROUND}, so the round
    the start button starts comes from config/round_select.yaml alone.
    `gorur-round open|obstacle` now edits that file's round: line (and
    restarts the service) instead of /etc/default/gorur, and also shows the
    start delay. install.sh comments out a leftover GORUR_ROUND line and says
    so, printing its old value. GORUR_ROUND_ARGS="round:=..." still
    overrides the file without editing it.
2026-11-12 autonomy: start_delay_sec 3 -> 5 s to match the LED countdown
    The firmware's start countdown is now 5 s for every press, whichever
    driver is running. The autonomy drivers (open_round_run,
    disparity_extender, new_disparity), their launch files, the sim
    launches and disparity_extender_params.yaml move to 5.0 so the car
    still starts the moment the LED stops blinking.
2026-11-12 docs: 5 s start countdown, and where the boot round is chosen
    README, QUICKSTART, the circuit diagram notes and the pin map now describe
    the five-blink, 5 s start countdown. QUICKSTART points at
    ros2_ws/config/round_select.yaml for which round the button starts.
2026-11-12 ADDED IMU IMPROVISED OPEN ROUND AND OBSTACLE ROUND
